miirage-exe/web-wii-embedded/README.md

The website used in this project can be reached at https://web-wii.couseran.fr, and is hosted on an OVH VPS.
The source code of this website can be seen at: https://github.com/miirage-exe/web-wii-app
