miirage-exe/web-wii-embedded/report/report.tex

\documentclass[12pt, a4paper]{article}

% Packages
\usepackage[T1]{fontenc}
\usepackage[utf8]{inputenc}
\usepackage{lmodern}
\usepackage[a4paper, margin=2.5cm]{geometry}
\usepackage{graphicx}
\usepackage{amsmath}
\usepackage{amssymb}
\usepackage{hyperref}
\usepackage{listings}
\usepackage{xcolor}
\usepackage{booktabs}
\usepackage{float}
\usepackage{caption}
\usepackage{subcaption}
\usepackage{parskip}
\usepackage{titlesec}
\usepackage{fancyhdr}
\usepackage{enumitem}

\hypersetup{
    colorlinks=true,
    linkcolor=black,
    citecolor=black,
    urlcolor=blue
}

\lstset{
    language=C++,
    basicstyle=\ttfamily\small,
    keywordstyle=\color{blue}\bfseries,
    commentstyle=\color{gray}\itshape,
    stringstyle=\color{red},
    numbers=left,
    numberstyle=\tiny\color{gray},
    frame=single,
    breaklines=true,
    captionpos=b
}

\newtheorem{remark}{Remark}
\newtheorem{definition}{Definition}

\title{SEES Project - Web Wii}
\author{Mika Baëza, Mohammad Parto, Kawtar Bidoukhach}
\date{April 2026}

\begin{document}

\maketitle

\tableofcontents

\section{Introduction} 

In 2006, Nintendo introduced its new console to the public: the Nintendo Wii. At the time, this game console was a breakthrough due to the specificity of its controller, the \textit{Wii Remote}. The particularity of this remote is its ability to act as an intuitive pointing device. The Wii Remote can be seen as a laser pointer, except that the position it points to on screen becomes a cursor, allowing users to interact with on-screen elements in a natural and intuitive way.

In this project, we aimed to recreate this intuitive device using modern embedded hardware. The system consists of one Adafruit Metro ESP32-S3 boards communicating over Bluetooth Low Energy (BLE) to a webpage opened on a PC.

This report describes the system architecture, hardware design, sensor modelling, firmware implementation, and experimental results of this project.

\section{Background}

\subsection{The Original Wii Remote}

The Nintendo Wii Remote achieves its pointing and motion-sensing capabilities through two complementary subsystems: an infrared camera and an accelerometer.

\paragraph{IR-based pointing.}
The \textit{sensor bar} bundled with the Wii console is entirely passive: it contains a pair of infrared LEDs at each end of a $\sim$20\,cm bar and transmits no data~\cite{wiibrew}. All sensing occurs inside the remote, which contains a forward-facing IR camera. This camera detects up to four IR sources and outputs their 2D image-plane coordinates directly~\cite{wiibrew}. From the known physical separation of the two LED clusters, the console software infers where the remote is pointing on screen. The sensor bar is nothing more than a pair of fixed IR beacons: any two IR LEDs at a known separation can serve as a functional substitute.

\paragraph{Accelerometer.}
The original Wii Remote included a 3-axis accelerometer for gesture and tilt sensing, but lacked independent rotational tracking. This was addressed in 2009 with the Wii\,MotionPlus accessory, which added a multi-axis MEMS gyroscope~\cite{motionplus_wiki}. 

\paragraph{Relevance to this project.}
This project mostly mirrors the same architecture: two fixed IR LEDs replace the sensor bar, and the remote's IR camera tracks them to derive cursor coordinates. Anyway, for this project, we decided to use a IMU that combines accelerometer and gyroscope data to give a ready-to-use orientation data, since our goal is to just have a pointing device, and not detect any shaking or other user movement. Thereofre having directly the orientation of the remote makes the computation of the cursor position easier.

\subsection{Bluetooth Low Energy (BLE)}

BLE organises data exchange around the \textit{Generic Attribute Profile} (GATT) model. A \textit{peripheral} device exposes one or more \textit{services}, each containing one or more \textit{characteristics}. A \textit{central} device (here, the browser running on the PC) can read, write, or subscribe to those characteristics. In this project the remote acts as the peripheral, advertising a single service with one characteristic that carries the cursor packet.

Two transfer modes are available for characteristics. In \textit{polling}, the central explicitly reads the characteristic at whatever rate it chooses. With \textit{notifications}, the peripheral pushes an updated value to all subscribed centrals as soon as it is ready. Notifications were preferred here: they invert the flow of control so the remote drives the update rate, and deliver data at the sensor cadence without requiring the central to time its reads precisely, allowing a future potential implementation of a \textit{sleep mode} (not implemented in the scope of this project).

BLE was chosen over Wi-Fi for two practical reasons. First, BLE introduces lower and more predictable per-packet latency, which is important for a real-time pointing device. Second, BLE consumes significantly less power than Wi-Fi, a relevant constraint for a battery-powered handheld unit.

\subsection{Inertial Measurement Units and Sensor Fusion}

An \textit{Inertial Measurement Unit} (IMU) is a device that measures the forces and rotational rates acting on a rigid body. A typical IMU combines an \textit{accelerometer}, which measures linear acceleration along three axes, a \textit{gyroscope}, which measures angular velocity around three axes, and optionally a \textit{magnetometer}, which measures the local magnetic field to provide an absolute heading reference.

Raw data from each sensor is individually imperfect: accelerometers are noisy and sensitive to vibration, while gyroscopes suffer from drift as integration errors accumulate over time. \textit{Sensor fusion} combines both sources to produce an orientation estimate that is more accurate and stable than either alone.

The BNO085 used in this project integrates all three sensor types on a single chip and runs its own fusion algorithm in dedicated hardware~\cite{bno085}. It exposes the final orientation directly as Euler angles (yaw, pitch, roll) at 100\,Hz. This removes the need to implement a fusion filter manually and simplifies the firmware to a single serial read per cycle.

\subsection{IR-Based Pointing and Perspective Projection}

The pointing subsystem relies on a passive reference bar containing two IR LEDs separated by a fixed distance of 200\,mm, placed on top of the screen. The remote's onboard IR camera (DFRobot SEN0158) detects up to four IR sources and reports their pixel coordinates over I2C~\cite{ir_camera}. In normal operation, only the two reference LEDs are visible, so only the first two reported points are used.

The camera operates at a resolution of $1024 \times 768$\,px with a horizontal field of view of $33\deg$ and a vertical field of view of $23\deg$. Because in our case the camera is mounted sideways in the remote, its width and height axes are physically swapped relative to the world orientation; the firmware accounts for this by exchanging the $W$ and $H$ parameters, and the $x$ and $y$ values of any sensor read (see after).

The 2-D pixel observations are converted into a 3-D cursor position through a perspective back-projection, detailed in Annex~\ref{annex:localisation}. Each observed pixel $(u_i, v_i)$ defines a ray direction $\mathbf{d}_i$ in the camera frame, which is rotated into the global frame using the IMU orientation. The 3-D position of the remote is then recovered by finding the point best consistent with both observed pixels. The 2-D cursor coordinates are finally obtained by intersecting the remote's pointing ray with the screen plane, defined as $Y = 0$ in the global frame.

\section{Description}

\subsection{System Architecture}

The system is composed of one ESP32-S3 boards exclusively over BLE with a web page, and a reference device placed on top of the screen.

\paragraph{Remote board} The handheld unit is battery-powered and hosts a BNO085 IMU (UART) for orientation sensing, an IR Camera which tracks the IR LEDs on the reference device to extract cursor coordinates, and several buttons. It acts as a BLE \textit{peripheral} (forwarding data to the PC) at maximum 100\,Hz.

\paragraph{Reference device} The reference device is USB-powered and hosts two IR leds separated of 20cm,  It does not contain any internal logic and is just used as a reference line for the remote IR camera. 
Figure~\ref{fig:architecture} shows the overall system block diagram.

\paragraph{Web page}
The user interface is implemented as a web page built with Svelte and SvelteKit. Communication with the remote is handled through the Web Bluetooth API~\cite{chrome_bluetooth}, supported natively in Google Chrome since version~56, which allows a web page to connect directly to a BLE peripheral without any native application or driver.

Figure~\ref{fig:architecture} shows the overall system block diagram.

\begin{figure}[H]
    \centering
    % \includegraphics[width=0.85\textwidth]{figures/architecture.png}
    
    \caption{System architecture: Remote $\xrightarrow{\text{BLE}}$ PC}
    \label{fig:architecture}
\end{figure}

% \subsection{Hardware Design}

\subsection{Cursor Estimation}

The goal of cursor estimation is to recover the 3-D position
$\mathbf{P} = (p_x,\, p_y,\, p_z)^\top$ of the remote in the global frame
from two pieces of information: the IMU orientation and the pixel coordinates
of the two IR beacons observed by the on-board camera.

The IR camera back-projects each observed pixel $(u_i, v_i)$ into a ray
direction $\mathbf{d}_i$ in the camera frame using the
known camera intrinsics (focal lengths $f_x$, $f_y$ derived from the sensor's
field of view). Each ray is then rotated into the global frame using the
rotation matrix $\mathbf{R}$ built from the IMU's yaw, pitch and roll:
\begin{equation}
    \mathbf{r}_i = \mathbf{R}\,\mathbf{d}_i, \qquad i = 1, 2.
\end{equation}

Since each beacon $L_i$ must lie along its corresponding ray, the remote's
position satisfies $\mathbf{P} = L_i - \lambda_i\,\mathbf{r}_i$ for some
scalar depth $\lambda_i > 0$. Solving the equation of the two expressions for $\mathbf{P}$
leads to an overdetermined $3 \times 2$ linear system in $(\lambda_1, \lambda_2)$,
which is solved in closed form by least squares. The final position estimate is:
\begin{equation}
    \mathbf{P} = \frac{1}{2}\bigl[
        (L_1 - \lambda_1\,\mathbf{r}_1) + (L_2 - \lambda_2\,\mathbf{r}_2)
    \bigr].
\end{equation}

The system is well-conditioned as long as the two beacons do not project onto
the same pixel, which is guaranteed whenever the reference bar is visible.
The full derivation, including the explicit closed-form expressions for
$\lambda_1$ and $\lambda_2$, is given in Annex~\ref{annex:localisation}.
\subsection{BLE Communication Protocol}

The remote transmits a 14-byte packet to the console at $\sim$100\,Hz:

\begin{lstlisting}[caption={BLE packet structure (remote $\to$ PC)}, label={lst:packet}]
struct RemotePacket {
    int32_t x;           // mm * 100       (4 bytes)
    int32_t y;           // mm * 100       (4 bytes)
    int32_t pitch;       // degrees * 100  (4 bytes)
    uint8_t buttonMask;  // bitmask        (1 byte)
    uint8_t missMask;    // bitmask        (1 byte)
};                       // Total: 14 bytes
\end{lstlisting}

% TODO: explain why we used 32bit int: mainly for readability (for both x/y and pitch).

\subsection{Firmware Design}

The remote firmware was written in C++ with Arduino IDE. It follows a straightforward loop: read the IMU, read the IR camera, read the buttons, compute the cursor position, and push a BLE notification (all within a 10\,ms window to sustain the 100\,Hz target rate). Each hardware peripheral is encapsulated in its own initialisation and read function, keeping the main loop compact.

\paragraph{BNO085 initialisation and reading.}
The BNO085 is operated in its UART~RVC (Raw Vector Continuous) mode. Although the sensor exposes an I2C interface, its datasheet notes that it is not compatible with the I2C specification~\cite{bno085}, which caused compatibility issues with the ESP32-S3. The UART protocol was used instead. More specificatlly UART-RVC was preferred because this the board only needs to \textit{receive} orientation data from the sensor (nothing needs to be sent back). UART~RVC is designed precisely for this case, reducing the firmware interaction to a single read per cycle. The \texttt{Adafruit\_BNO08x\_RVC} library handles frame synchronisation and parsing over a dedicated hardware UART (Serial1, 115200\,baud, pins 4 and 5).

In consequence, because the BNO085 transmits frames continuously (and asynchronously), a read attempt may catch the UART buffer mid-frame. If the first \texttt{rvc.read()} call fails, the firmware waits 3\,ms, and retries once before declaring the reading as missed.

A calibration offset is maintained for each axis. On every read, the raw Euler angles output by the sensor are corrected by subtracted by the offset, so that the resting orientation of the remote reads as $(0, 0, 0)$ (pointing toward the center of the screen). The offset is updated whenever the user presses button~B, capturing the current orientation as the new zero reference. Additionally, the firmware forces ten automatic resets during the first ten loop cycles at power-on, so the remote self-calibrates to whatever orientation it happens to be held in at start-up (ideally pointing to the center of the screen).

\paragraph{IR camera initialisation and reading.}
The DFRobot SEN0158 IR positioning camera is connected over I\textsuperscript{2}C at address \texttt{0x58} (shifted from the raw sensor address \texttt{0xB0}). On the board the camera is connected to the sefault SDA and SCL port. Initialisation consists of writing a fixed six-register sequence that configures the camera's sensitivity and output format, as specified in the datasheet~\cite{ir_camera}.

Each read requests 16 bytes from register \texttt{0x36}. The camera encodes the pixel coordinates of up to four detected IR sources across those bytes, with two upper bits of each coordinate packed into a shared status byte. A coordinate value of 1023 signals that the corresponding source was not detected; if either of the first two spots reports this default value, the read is declared as missed and the firmware retains the last valid position.

Because the camera is mounted sideways in the remote enclosure, its reported $x$ and $y$axes are physically transposed relative to the world frame. The firmware corrects this by swapping the pixel components before writing them into the sensor payload.

\paragraph{Button reading and encoding.}
Two push-buttons are connected to GPIO pins~7 and~9 and configured as digital inputs. Button~A (pin~7) is the action button: its state is read each cycle and encoded into bit~0 of the \texttt{buttonMask} byte included in the BLE payload. Button~B (pin~9) is a reset button that triggers a gyroscope origin reset when held; it is not forwarded to the host.

\paragraph{BLE peripheral setup.}
The ESP32 is configured as a BLE peripheral under the device name \texttt{WiiRemote}. A single GATT service is created with one characteristic that carries the cursor payload; the characteristic is declared with the \texttt{READ}, \texttt{WRITE} and \texttt{NOTIFY} properties, enabling the web client to subscribe to updates. Two custom 128-bit UUIDs identify the service and characteristic, ensuring the browser-side Web Bluetooth connection request can uniquely target the remote.

A server callback handles connection events. On connect, the \texttt{computerConnected} flag is set and the status LED turns white. On disconnect, the flag is cleared and BLE advertising is restarted after a 1\,s debounce delay, making the remote immediately discoverable again without requiring a reboot.

\paragraph{Cursor computation.}
Once the sensor readings are available, the firmware calls \texttt{localise\_remote()}, which converts the IMU Euler angles (degrees to radians) and the two IR pixel pairs into a 3-D position vector and a pointing-direction ray in the global frame, following the algorithm described in Annex~\ref{annex:localisation}. If the computation fails (either because the two rays are nearly parallel ($\delta < 10^{-9}$) or because one of the recovered depths $\lambda_i$ is negative) the function returns \texttt{false} and bit~2 of the miss mask is set.

\begin{remark}[Axis assignment in the firmware]
The physical mounting of the BNO085 on the remote imposes an axis assignment that differs from the convention defined in Annex~\ref{annex:localisation}: $Y$ serves as the depth axis where the appendix uses $Z$, and $Z$ is the vertical axis where the appendix uses $Y$. The localisation algorithm is otherwise identical; only the axis labels differ.
\end{remark}

The 3-D position is then projected onto the screen plane ($Y = 0$ in the global frame) by ray casting: the parameter $t = -p_y / r_y$ gives the intersection, and the cursor coordinates follow as $(p_x + t\,r_x,\; p_z + t\,r_z)$. Both coordinates and the pitch angle are scaled by a factor of 100 and stored as \texttt{int32\_t}, providing two decimal places of precision while avoiding floating-point in the BLE payload.

\paragraph{Main loop and timing.}
The loop is driven by a \texttt{millis()} timer that fires every \texttt{NOTIFY\_INTERVAL\_MS}\,$= 10$\,ms ($\approx$100\,Hz). Within each tick, the firmware executes the pipeline in order: read the gyroscope, optionally reset the gyroscope origin, read the IR camera, update the board state, assemble the cursor payload, and push a BLE notification.

Failures at each stage are tracked through a three-bit \texttt{MISS\_MASK}: bit~0 signals a missed IMU frame, bit~1 a missing IR beacon, and bit~2 a failed localisation. The mask is included in every BLE packet so the host can distinguish invalid cursor computations from valid ones. The onboard NeoPixel LED also reflects the mask: it turns off for any non-zero value and returns to its normal colour when all three stages succeed. A debug dump of all intermediate values is printed to the serial monitor once per second.

\section{Experimental Results and Conclusion}

\subsection{Limitations and Trade-offs}

\paragraph{IR LED emission angle.}
The IR LEDs used on the reference device have a narrow emission cone of approximately 20°. When the remote is pointed too far off-axis relative to the reference bar, the IR camera loses track of one or both beacons, causing cursor tracking to fail. This is not a fundamental limitation of the pointing algorithm but rather a consequence of the specific LEDs chosen. Replacing our current LEDS with wider-angle IR emitters would directly extend the usable pointing range without any software change.

\paragraph{BNO085 sensor fusion inertia.}
The BNO085 onboard fusion algorithm prioritises orientation stability over instantaneous responsiveness. In practice, this introduces a slight lag on fast rotational movements, making rapid gestures feel softly delayed on screen.

\paragraph{Browser compatibility.}
The Web Bluetooth API is currently only supported in Chromium-based browsers~\cite{chrome_bluetooth}, restricting the system to Chrome, Edge or Brave etc... on desktop. Safari and Firefox do not implement the API, which limits the portability of the web interface.

\subsection{Conclusion}

This project successfully reproduced the core experience of the Nintendo Wii Remote using modern embedded hardware. The full system pipeline — IR-based cursor pointing, absolute orientation sensing, button input, BLE transmission, and web-based rendering demonstrated that such an interface can be built with modern components and a browser as the only software dependency for the user.

Two practical limitations were identified during use. First, the IR LEDs used on the reference device have a narrow $\sim$20° emission cone. This is an inherent constraint of the chosen LEDs rather than of the pointing algorithm, and could be addressed by substituting wider-angle IR emitters. Second, the BNO085's onboard sensor fusion introduces a slight inertia on fast rotational movements, causing a perceptible lag between physical gesture and on-screen response. This is a known trade-off of gyroscope-based fusion filters, which prioritise stability over instantaneous responsiveness.

Overall, the system met the objectives of the project. The design validates the use of a passive IR reference, an onboard fusion IMU, and the Web Bluetooth API as a viable and accessible stack for building motion-controlled pointing devices, with no native software required on the host machine.

\section*{AI Disclosure}

This document was written by the authors. Generative AI tools were used to assist with the formulation of certain passages and the \LaTeX{} typesetting. All content and results were reviewed and validated by the authors.

\section{References}
\begin{thebibliography}{99}

\bibitem{motionplus_wiki}
Wikipedia, \textit{Wii MotionPlus}.
\url{https://en.wikipedia.org/wiki/Wii_MotionPlus}

\bibitem{motionplus_iwata}
Nintendo, \textit{Iwata Asks: Wii MotionPlus --- Combining Two Sensors}, 2009.
\url{https://www.nintendo.com/en-gb/Iwata-Asks/Iwata-Asks-Wii-MotionPlus/Read-more/2-Combining-Two-Sensors/2-Combining-Two-Sensors-225646.html}

\bibitem{wiibrew}
Wiibrew, \textit{Wiimote wiki}.
\url{https://wiibrew.org/wiki/Wiimote}

\bibitem{chrome_bluetooth}
F.\ Beaufort, \textit{Communicating with Bluetooth Devices over JavaScript},
Google Chrome for Developers, 2015.
\url{https://developer.chrome.com/docs/capabilities/bluetooth}

\bibitem{web_bluetooth}
MDN Web Docs, \textit{Web Bluetooth API}.
\url{https://developer.mozilla.org/en-US/docs/Web/API/Web_Bluetooth_API}

\bibitem{bno085}
Adafruit Industries, \textit{BNO085 Datasheet}, 2025.
\url{https://cdn-learn.adafruit.com/downloads/pdf/adafruit-9-dof-orientation-imu-fusion-breakout-bno085.pdf}

\bibitem{ir_camera}
DFRobot, \textit{Gravity: IR Positioning Camera Datasheet}, 2025.
\url{https://mm.digikey.com/Volume0/opasdata/d220001/medias/docus/2148/Positioning_IR_Camera_Web.pdf}

\end{thebibliography}

\newpage
\appendix

\section{3-D Localisation of the Remote}
\label{annex:localisation}

\subsection{Problem Statement}

\subsubsection{Goal}
Recover the 3-D position $\mathbf{P} = (p_x,\, p_y,\, p_z)^\top \in \mathbb{R}^3$ of a Wii remote
in a fixed global frame $\mathcal{O}$, given:
\begin{itemize}[nosep]
    \item the orientation of the remote expressed as Euler angles
          (yaw $\psi$, pitch $\theta$, roll $\phi$);
    \item the pixel coordinates of two infrared beacons captured by the
          remote's on-board camera;
    \item the intrinsic parameters of that camera.
\end{itemize}

\subsubsection{Known quantities}
\begin{itemize}[nosep]
    \item Two beacons fixed in the global frame:
          $L_1 = (d,\,0,\,0)^\top$ and $L_2 = (-d,\,0,\,0)^\top$,
          separated by a known distance $2d$.
    \item Their projections on the camera sensor:
          $(u_1^{\text{raw}},\, v_1^{\text{raw}})$ and
          $(u_2^{\text{raw}},\, v_2^{\text{raw}})$.
    \item Camera intrinsics: image resolution $(W, H)$, horizontal field of
          view $\theta_w$, vertical field of view $\theta_h$.
\end{itemize}

\subsubsection{Reference frames}
\begin{definition}[Global frame $\mathcal{O}$]
Fixed, world-attached frame with axes $(X, Y, Z)$.
The beacons $L_1$, $L_2$ are given in this frame.
\end{definition}
\begin{definition}[Remote frame $\mathcal{R}$]
Attached to the remote. Its origin coincides with the camera optical centre
$\mathbf{P}$; its axes are the global axes rotated by the known Euler angles.
All camera-model equations hold in this frame.
\end{definition}

\subsubsection{Axis convention}
The global frame $\mathcal{O}$ is oriented as follows: $X$ runs horizontally along the reference bar (with $L_1$ on the positive side), $Y$ is the vertical axis pointing upward, and $Z$ is the depth axis pointing from the screen toward the remote. In particular, the screen plane is $Z = 0$ and the remote always sits at $Z > 0$.

% ─────────────────────────────────────────────────────────────────────────────
\subsection{Step 1 — Rotation Matrix from Euler Angles}

\subsubsection{Elementary rotation matrices}
Three elementary rotations are defined about the $Z$, $Y$, and $X$ axes
respectively:

\begin{equation}
R_z(\psi) =
\begin{pmatrix}
\cos\psi & -\sin\psi & 0 \\
\sin\psi &  \cos\psi & 0 \\
0        &  0        & 1
\end{pmatrix},
\quad
R_y(\theta) =
\begin{pmatrix}
 \cos\theta & 0 & \sin\theta \\
 0          & 1 & 0          \\
-\sin\theta & 0 & \cos\theta
\end{pmatrix},
\quad
R_x(\phi) =
\begin{pmatrix}
1 & 0       &  0      \\
0 & \cos\phi & -\sin\phi \\
0 & \sin\phi &  \cos\phi
\end{pmatrix}.
\end{equation}

\subsubsection{ZYX composition (intrinsic yaw–pitch–roll)}
Using the \emph{ZYX} intrinsic convention (first yaw about $Z$, then pitch
about the new $Y$, then roll about the new $X$), the global-to-remote
rotation matrix is:

\begin{equation}
\mathbf{R} = R_z(\psi)\,R_y(\theta)\,R_x(\phi).
\end{equation}

\subsubsection{Explicit expanded form}
Defining the shorthand $c_\alpha \equiv \cos\alpha$, $s_\alpha \equiv \sin\alpha$:

\begin{equation}
\mathbf{R} =
\begin{pmatrix}
c_\psi c_\theta &
  c_\psi s_\theta s_\phi - s_\psi c_\phi &
  c_\psi s_\theta c_\phi + s_\psi s_\phi \\[4pt]
s_\psi c_\theta &
  s_\psi s_\theta s_\phi + c_\psi c_\phi &
  s_\psi s_\theta c_\phi - c_\psi s_\phi \\[4pt]
-s_\theta &
  c_\theta s_\phi &
  c_\theta c_\phi
\end{pmatrix}.
\label{eq:R}
\end{equation}

\subsubsection{Key property}
Because $\mathbf{R}$ is orthogonal ($\mathbf{R}^\top \mathbf{R} = I_3$), its
inverse equals its transpose:
\begin{equation}
\mathbf{R}^{-1} = \mathbf{R}^\top.
\end{equation}
$\mathbf{R}$ transforms vectors from $\mathcal{O}$ to $\mathcal{R}$;
$\mathbf{R}^\top$ transforms from $\mathcal{R}$ back to $\mathcal{O}$.

% ─────────────────────────────────────────────────────────────────────────────
\subsection{Step 2 — Camera Intrinsic Model}

\subsubsection{From FOV angles to pixel focal lengths}
The pinhole camera geometry links the physical field of view to the focal
length expressed in pixels. For the horizontal axis, half the image width
subtends half the horizontal FOV:

\begin{equation}
\tan\!\left(\frac{\theta_w}{2}\right) = \frac{W/2}{f_x}
\quad\Longrightarrow\quad
\boxed{f_x = \frac{W}{2\tan\!\left(\theta_w/2\right)}}.
\end{equation}

Likewise for the vertical axis:

\begin{equation}
\tan\!\left(\frac{\theta_h}{2}\right) = \frac{H/2}{f_y}
\quad\Longrightarrow\quad
\boxed{f_y = \frac{H}{2\tan\!\left(\theta_h/2\right)}}.
\end{equation}

\begin{remark}
If $\theta_w/W = \theta_h/H$ the pixels are square and $f_x = f_y$.
Otherwise the camera has a non-unit pixel aspect ratio.
\end{remark}

\subsubsection{Principal point}
The optical axis intersects the sensor at its centre, called the
\emph{principal point}:

\begin{equation}
c_x = \frac{W}{2}, \qquad c_y = \frac{H}{2}.
\end{equation}

\subsubsection{Intrinsic matrix}
The four intrinsic parameters are assembled into the $3\times 3$ upper
triangular matrix:

\begin{equation}
K =
\begin{pmatrix}
f_x & 0   & c_x \\
0   & f_y & c_y \\
0   & 0   & 1
\end{pmatrix}.
\label{eq:K}
\end{equation}

\subsubsection{Projection equation}
A 3-D point $\mathbf{q} = (q_x, q_y, q_z)^\top$ in the remote frame
$\mathcal{R}$ projects onto raw pixel coordinates via:

\begin{equation}
\begin{pmatrix} u^{\text{raw}} \\ v^{\text{raw}} \\ 1 \end{pmatrix}
\;\sim\;
K\,\begin{pmatrix} q_x/q_z \\ q_y/q_z \\ 1 \end{pmatrix},
\end{equation}

which gives explicitly:

\begin{equation}
u^{\text{raw}} = f_x\,\frac{q_x}{q_z} + c_x,
\qquad
v^{\text{raw}} = f_y\,\frac{q_y}{q_z} + c_y.
\label{eq:proj}
\end{equation}

\subsubsection{Back-projection: pixel to ray direction}
Inverting \eqref{eq:proj}, a raw pixel $(u^{\text{raw}}, v^{\text{raw}})$
defines a \emph{ray direction} in $\mathcal{R}$. Since $K$ is upper
triangular its inverse is:

\begin{equation}
K^{-1} =
\begin{pmatrix}
1/f_x & 0     & -c_x/f_x \\
0     & 1/f_y & -c_y/f_y \\
0     & 0     & 1
\end{pmatrix}.
\end{equation}

The normalised (homogeneous) direction vector for observation $i$ is:

\begin{equation}
\mathbf{d}_i = K^{-1}
\begin{pmatrix} u_i^{\text{raw}} \\ v_i^{\text{raw}} \\ 1 \end{pmatrix}
=
\begin{pmatrix}
(u_i^{\text{raw}} - c_x)/f_x \\
(v_i^{\text{raw}} - c_y)/f_y \\
1
\end{pmatrix}.
\label{eq:di}
\end{equation}

The beacon $L_i$ lies somewhere along the ray
$\{\,\lambda_i\,\mathbf{d}_i \mid \lambda_i > 0\,\}$ in frame $\mathcal{R}$.

% ─────────────────────────────────────────────────────────────────────────────
\subsection{Step 3 — World-Space Ray Directions}

\subsubsection{Rotating the camera-frame ray into the global frame}
The back-projection \eqref{eq:di} gives the direction $\mathbf{d}_i$ of the
ray towards beacon $L_i$ expressed in the remote frame $\mathcal{R}$.
Rotating it into the global frame $\mathcal{O}$ with $\mathbf{R}$ yields the
\emph{world-space ray direction}:

\begin{equation}
\mathbf{r}_i \;=\; \mathbf{R}\,\mathbf{d}_i \;\in\; \mathbb{R}^3.
\label{eq:ri}
\end{equation}

$\mathbf{r}_i$ is fully known, depending only on the known rotation
$\mathbf{R}$ and the observed pixel $\mathbf{d}_i$.

\subsubsection{Ray constraint in the global frame}
The beacon $L_i$ lies somewhere along the ray emanating from the camera
origin $\mathbf{P}$ in direction $\mathbf{r}_i$. Expressed entirely in
$\mathcal{O}$:

\begin{equation}
L_i - \mathbf{P} = \lambda_i\,\mathbf{r}_i, \qquad \lambda_i > 0.
\label{eq:ray_constraint}
\end{equation}

Rearranging, the position satisfies:

\begin{equation}
\boxed{\mathbf{P} = L_i - \lambda_i\,\mathbf{r}_i, \qquad i = 1, 2.}
\label{eq:P_from_lambda}
\end{equation}
% ─────────────────────────────────────────────────────────────────────────────
\subsection{Step 4 — Linear System for the Depths $\lambda_1, \lambda_2$}

\subsubsection{Equating the two position estimates}
Equation \eqref{eq:P_from_lambda} written for $i=1$ and $i=2$ must give the
same $\mathbf{P}$:

\begin{equation}
L_1 - \lambda_1\,\mathbf{r}_1 = L_2 - \lambda_2\,\mathbf{r}_2.
\end{equation}

Rearranging:

\begin{equation}
\lambda_1\,\mathbf{r}_1 - \lambda_2\,\mathbf{r}_2 = L_1 - L_2.
\label{eq:sys}
\end{equation}

\subsubsection{Right-hand side}
With $L_1 = (d,0,0)^\top$ and $L_2 = (-d,0,0)^\top$:

\begin{equation}
L_1 - L_2 = \begin{pmatrix} 2d \\ 0 \\ 0 \end{pmatrix}.
\end{equation}

\subsubsection{Matrix form}
Writing $\mathbf{r}_i = (r_x^i,\, r_y^i,\, r_z^i)^\top$, equation
\eqref{eq:sys} becomes:

\begin{equation}
\underbrace{
\begin{pmatrix}
r_x^1 & -r_x^2 \\
r_y^1 & -r_y^2 \\
r_z^1 & -r_z^2
\end{pmatrix}
}_{A\;\in\;\mathbb{R}^{3\times 2}}
\begin{pmatrix} \lambda_1 \\ \lambda_2 \end{pmatrix}
=
\begin{pmatrix} 2d \\ 0 \\ 0 \end{pmatrix}.
\label{eq:linear_system}
\end{equation}

\subsubsection{Least-squares solution}
System \eqref{eq:linear_system} is \emph{overdetermined} (3 equations,
2 unknowns). The least-squares solution minimises
$\|A\boldsymbol{\lambda} - \mathbf{b}\|^2$:

\begin{equation}
\begin{pmatrix} \lambda_1 \\ \lambda_2 \end{pmatrix}
= (A^\top A)^{-1}\,A^\top\,\mathbf{b},
\qquad \mathbf{b} = \begin{pmatrix} 2d \\ 0 \\ 0 \end{pmatrix}.
\label{eq:lstsq}
\end{equation}

\paragraph{Explicit form of $A^\top A$}
\begin{equation}
A^\top A =
\begin{pmatrix}
\|\mathbf{r}_1\|^2 & -\mathbf{r}_1\cdot\mathbf{r}_2 \\
-\mathbf{r}_1\cdot\mathbf{r}_2 & \|\mathbf{r}_2\|^2
\end{pmatrix}.
\end{equation}

Its determinant is:
\begin{equation}
\det(A^\top A) = \|\mathbf{r}_1\|^2\|\mathbf{r}_2\|^2
                - (\mathbf{r}_1\cdot\mathbf{r}_2)^2
              = \|\mathbf{r}_1 \times \mathbf{r}_2\|^2.
\end{equation}

This vanishes if and only if $\mathbf{r}_1 \parallel \mathbf{r}_2$, i.e.\ the
two beacons project onto the same pixel — a physically degenerate
configuration.

\paragraph{Explicit form of $A^\top \mathbf{b}$}
\begin{equation}
A^\top \mathbf{b} =
\begin{pmatrix}
2d\, r_x^1 \\ -2d\, r_x^2
\end{pmatrix}.
\end{equation}

\paragraph{Closed-form solution}
Let $\alpha = \|\mathbf{r}_1\|^2$, $\beta = \mathbf{r}_1\cdot\mathbf{r}_2$,
$\gamma = \|\mathbf{r}_2\|^2$, $\delta = \alpha\gamma - \beta^2$. Then:

\begin{equation}
\boxed{
\lambda_1 = \frac{2d}{\delta}\bigl(\gamma\, r_x^1 - \beta\, r_x^2\bigr),
\qquad
\lambda_2 = \frac{2d}{\delta}\bigl(\beta\, r_x^1 - \alpha\, r_x^2\bigr).
}
\label{eq:lambda_closed}
\end{equation}

% ─────────────────────────────────────────────────────────────────────────────
\subsection{Step 5 — Recovering the 3-D Position $\mathbf{P}$}

\subsubsection{Individual estimates}
From \eqref{eq:P_from_lambda}:
\begin{align}
\hat{\mathbf{P}}_1 &= L_1 - \lambda_1\,\mathbf{r}_1
= \begin{pmatrix}d\\0\\0\end{pmatrix}
- \lambda_1\,\mathbf{R}^\top\,\mathbf{d}_1, \\[6pt]
\hat{\mathbf{P}}_2 &= L_2 - \lambda_2\,\mathbf{r}_2
= \begin{pmatrix}-d\\0\\0\end{pmatrix}
- \lambda_2\,\mathbf{R}^\top\,\mathbf{d}_2.
\end{align}

\subsubsection{Final estimate}
In the noiseless case $\hat{\mathbf{P}}_1 = \hat{\mathbf{P}}_2$. With noise,
the average minimises the residual:

\begin{equation}
\boxed{
\mathbf{P} = \frac{\hat{\mathbf{P}}_1 + \hat{\mathbf{P}}_2}{2}.
}
\end{equation}

% ─────────────────────────────────────────────────────────────────────────────
\subsection{Complete Algorithm}

The full procedure is summarised below.

\begin{enumerate}
    \item \textbf{Build the rotation matrix.}
    Compute $\mathbf{R} = R_z(\psi)\,R_y(\theta)\,R_x(\phi)$
    using \eqref{eq:R}.

    \item \textbf{Compute intrinsic parameters.}
    \begin{equation*}
    f_x = \frac{W}{2\tan(\theta_w/2)},\quad
    f_y = \frac{H}{2\tan(\theta_h/2)},\quad
    c_x = \frac{W}{2},\quad c_y = \frac{H}{2}.
    \end{equation*}

    \item \textbf{Back-project pixel observations.}
    For $i = 1, 2$, compute $\mathbf{d}_i$ via \eqref{eq:di}.

    \item \textbf{Rotate rays in world frame.}
    $\mathbf{r}_i = \mathbf{R}\,\mathbf{d}_i$ (equation \eqref{eq:ri}).

    \item \textbf{Solve for depths.}
    Assemble $A$ from \eqref{eq:linear_system} and solve \eqref{eq:lstsq}
    to obtain $\lambda_1, \lambda_2$. The closed form is \eqref{eq:lambda_closed}.

    \item \textbf{Recover position.}
    $\mathbf{P} = \tfrac{1}{2}(L_1 - \lambda_1\mathbf{r}_1
                               + L_2 - \lambda_2\mathbf{r}_2)$.
\end{enumerate}

% ─────────────────────────────────────────────────────────────────────────────
\subsection{Remarks and Edge Cases}

\begin{remark}[Degeneracy]
The system is degenerate when $\mathbf{r}_1 \parallel \mathbf{r}_2$
($\delta = 0$). This happens only when the two beacons project onto
identical pixels in the image, which is physically impossible if the bar is
visible and the camera has finite resolution.
\end{remark}

\begin{remark}[Sign of $\lambda$]
Both depths must be positive ($\lambda_i > 0$) for the beacons to be in
front of the camera. A negative value indicates an inconsistent input
(e.g.\ swapped beacon identities or an Euler-angle sign error).
\end{remark}

% \begin{remark}[Square pixels]
% If $\theta_w / W = \theta_h / H$ then $f_x = f_y = f$ and the model reduces
% to the original single-parameter model with direction vectors
% $\mathbf{d}_i = ((u_i - c_x)/f,\; (v_i - c_y)/f,\; 1)^\top$.
% \end{remark}

% \begin{remark}[Noise robustness]
% The least-squares formulation in Step 4 automatically distributes pixel noise
% across all three coordinate equations. For higher accuracy under significant
% noise, one can iterate using the Gauss–Newton method on the full non-linear
% reprojection error.
% \end{remark}

\end{document}
