miirage-exe/web-wii-embedded/(commit log)

2026-05-04 feat: get camera data
2026-05-05 add reset button for gyro
2026-05-06 working prototype (todo: fiw pitch rotation leading to error)
2026-05-17 rename arduino code
